shams1802/Spot_RoboDog/spotMicro/assets/8_left_link2_config_step_1.png

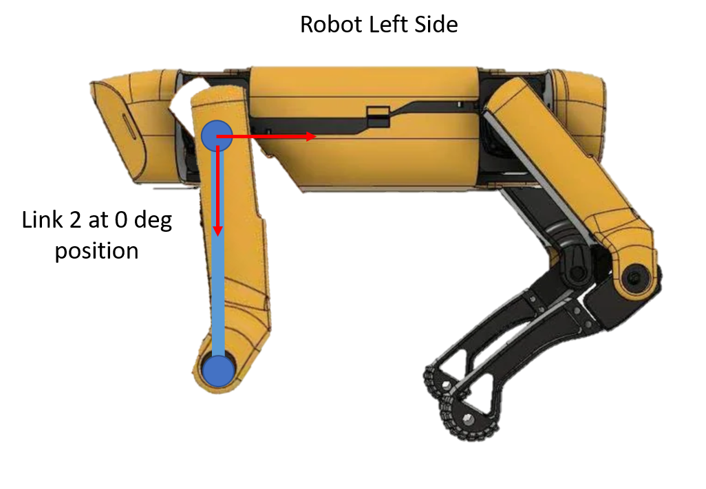
spotMicro/assets/8_left_link2_config_step_1.png
