shams1802/Spot_RoboDog/spotMicro/assets/9_left_link2_config_step_2.png

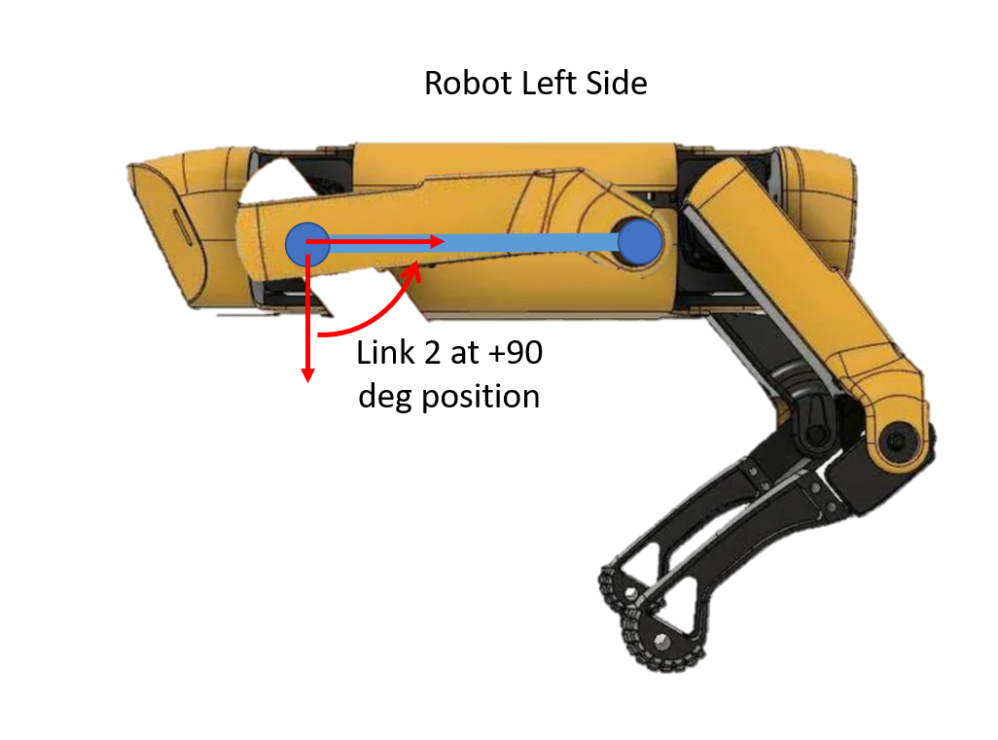
spotMicro/assets/9_left_link2_config_step_2.png
