shams1802/Spot_RoboDog/spotMicro/assets/1_robot_right_links.png

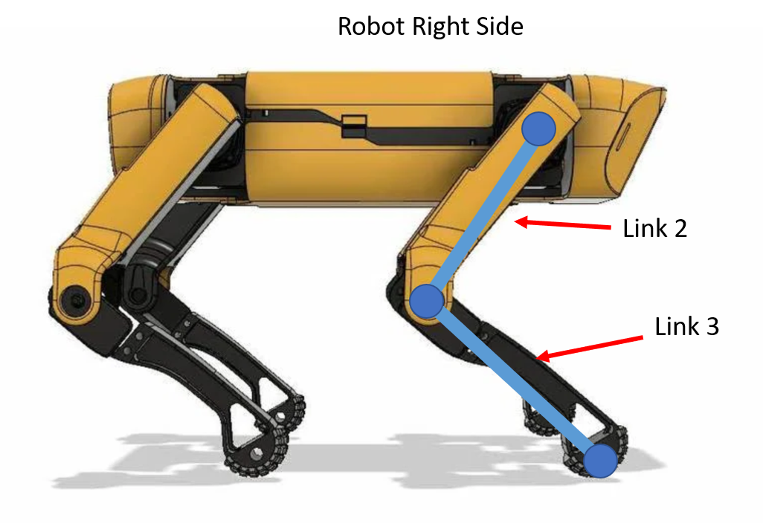
spotMicro/assets/1_robot_right_links.png
