shams1802/Spot_RoboDog/spotMicro/assets/2_right_straight_links.png

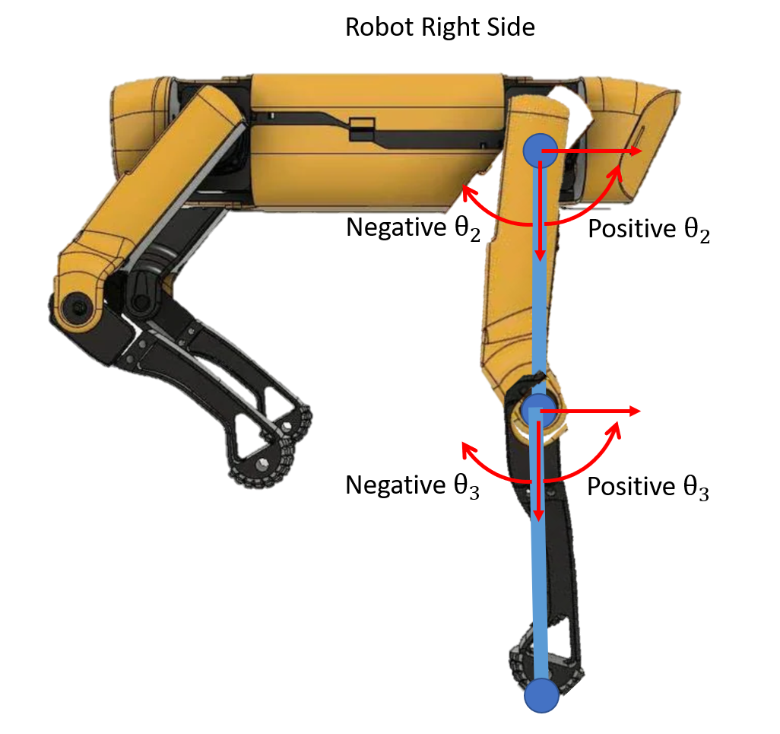
spotMicro/assets/2_right_straight_links.png
