shams1802/Spot_RoboDog/spotMicro/assets/3_right_link_angles_example.png

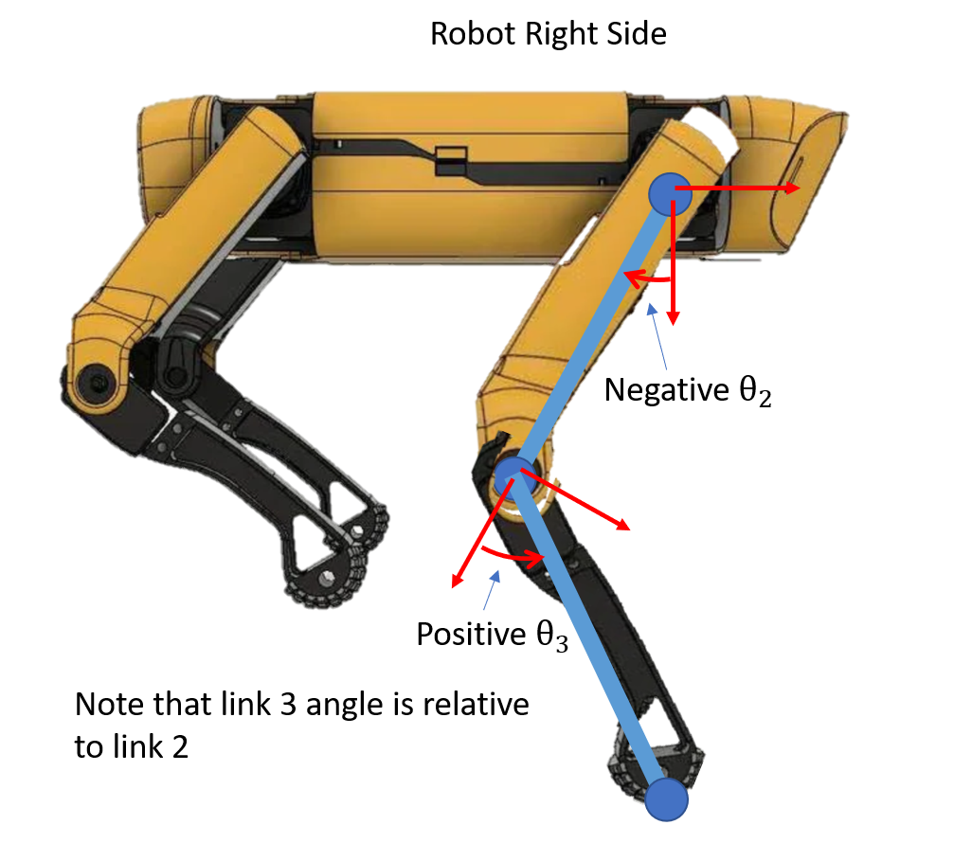
spotMicro/assets/3_right_link_angles_example.png
