shams1802/Spot_RoboDog/spotMicro/assets/7_robot_left_overview.png

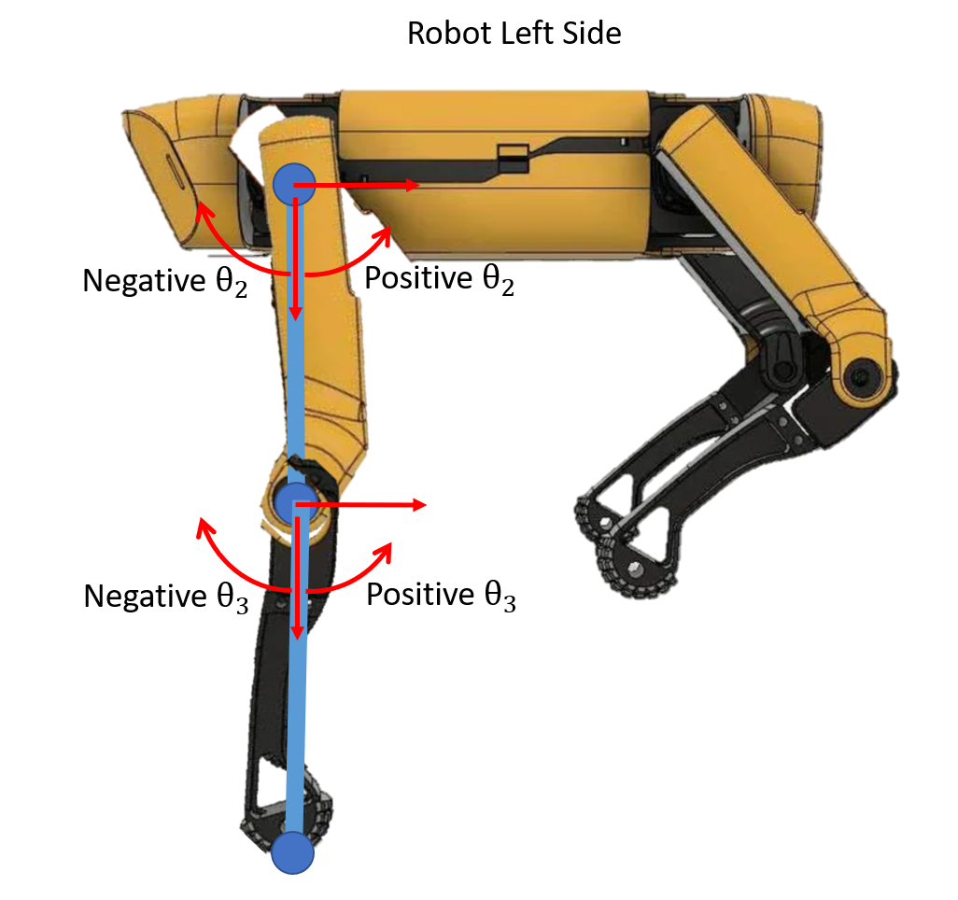
spotMicro/assets/7_robot_left_overview.png
