shams1802/Spot_RoboDog/spotMicro/assets/12_robot_back_overview.png

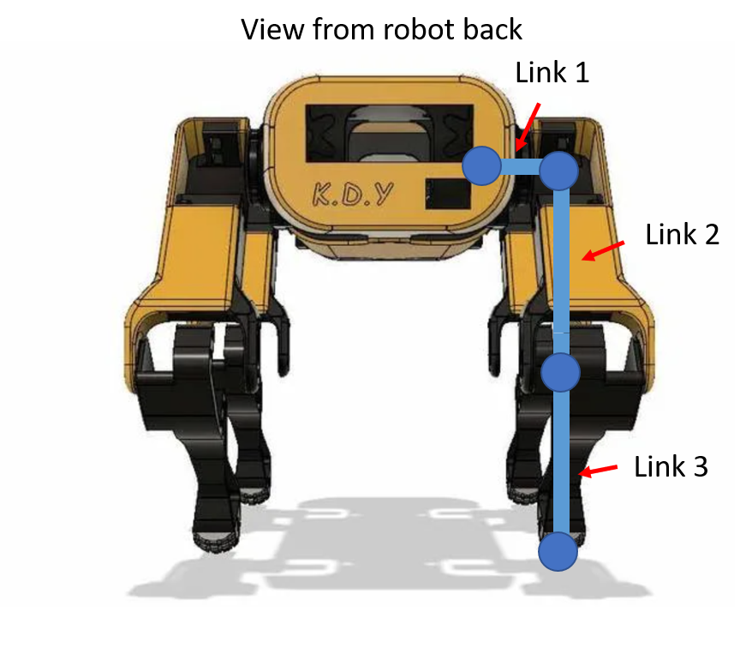
spotMicro/assets/12_robot_back_overview.png
