shams1802/Spot_RoboDog/spotMicro/assets/kinematic_coord_system.jpg

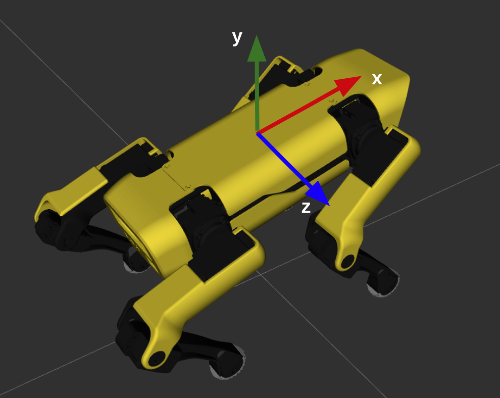
spotMicro/assets/kinematic_coord_system.jpg
