shams1802/Spot_RoboDog/spotMicro/assets/lidar_mount.jpg

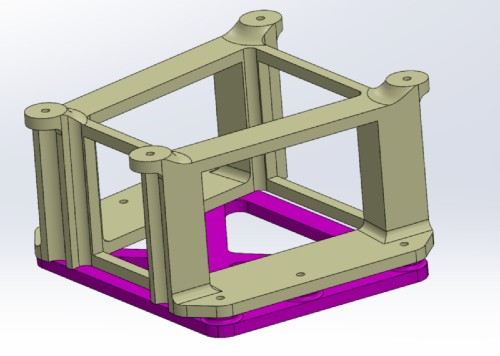
spotMicro/assets/lidar_mount.jpg
