shams1802/Spot_RoboDog/spotMicro/assets/robot_bottom.jpg

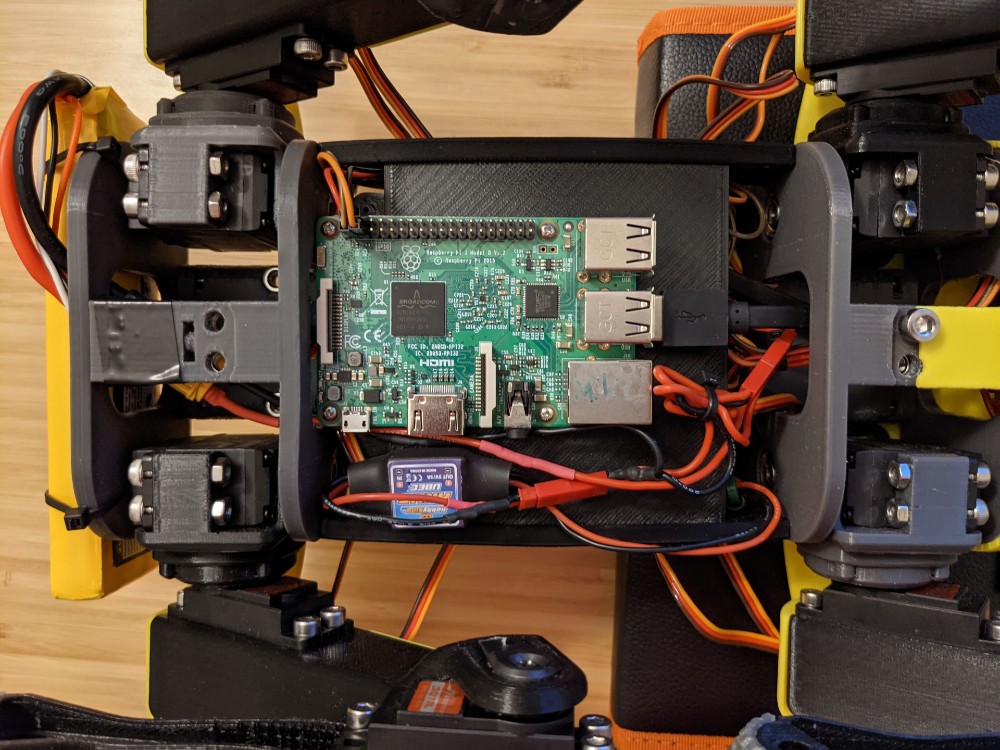
spotMicro/assets/robot_bottom.jpg
