shams1802/Spot_RoboDog/spotMicro/assets/robot_top.jpg

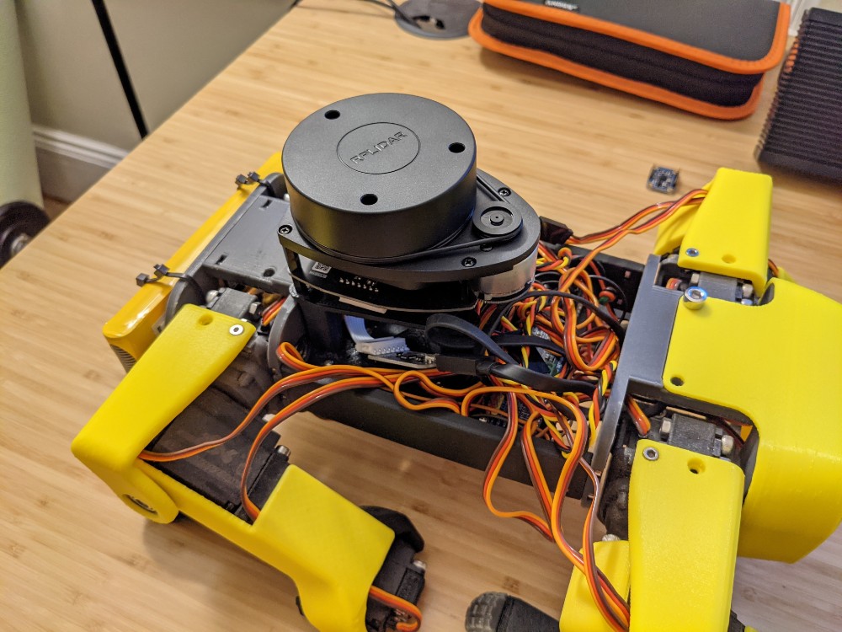
spotMicro/assets/robot_top.jpg
