shams1802/Spot_RoboDog/spotMicro/assets/robot_top_no_servos.jpg

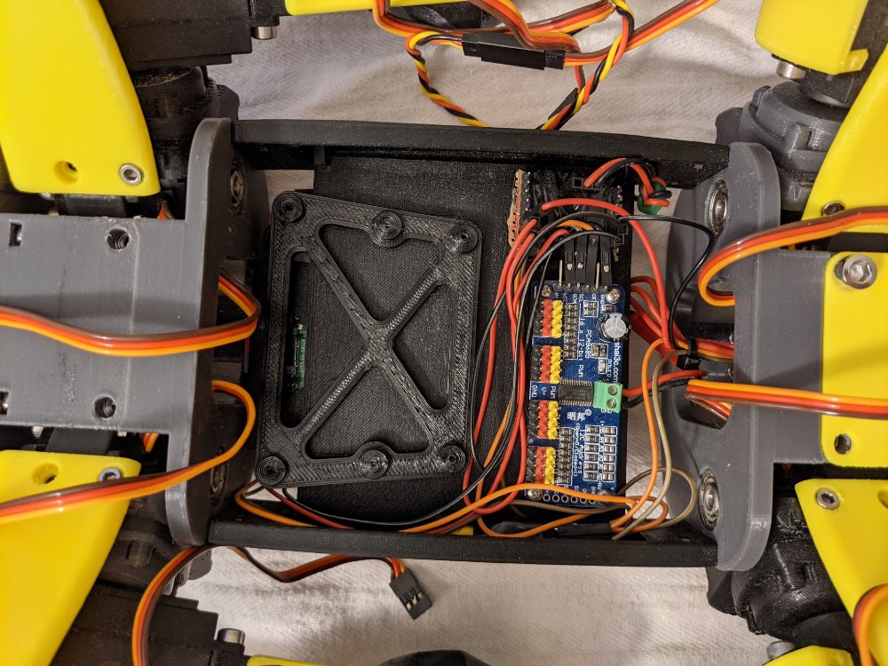
spotMicro/assets/robot_top_no_servos.jpg
