shams1802/Spot_RoboDog/spotMicro/assets/rpi_platform.jpg

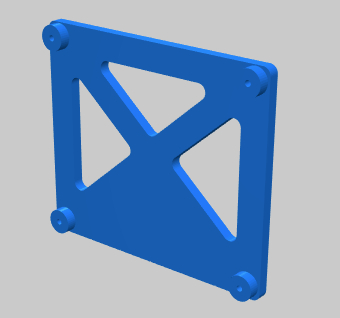
spotMicro/assets/rpi_platform.jpg
