shams1802/Spot_RoboDog/spotMicro/assets/rviz_animation.gif

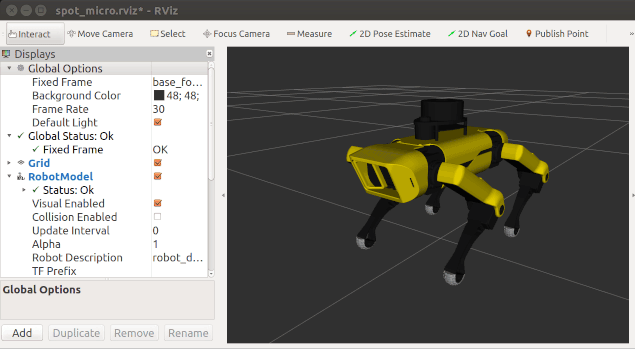
spotMicro/assets/rviz_animation.gif
