shams1802/Spot_RoboDog/spotMicro/assets/servo_move_prompt.png

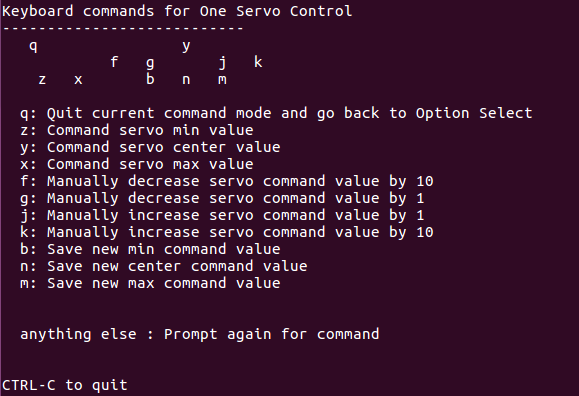
spotMicro/assets/servo_move_prompt.png
