shams1802/Spot_RoboDog/spotMicro/assets/spot_micro_slam.gif

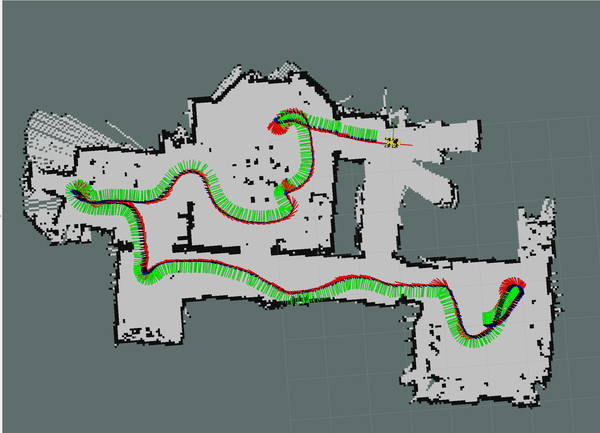
spotMicro/assets/spot_micro_slam.gif
