shams1802/Spot_RoboDog/spotMicro/assets/state_machine.png

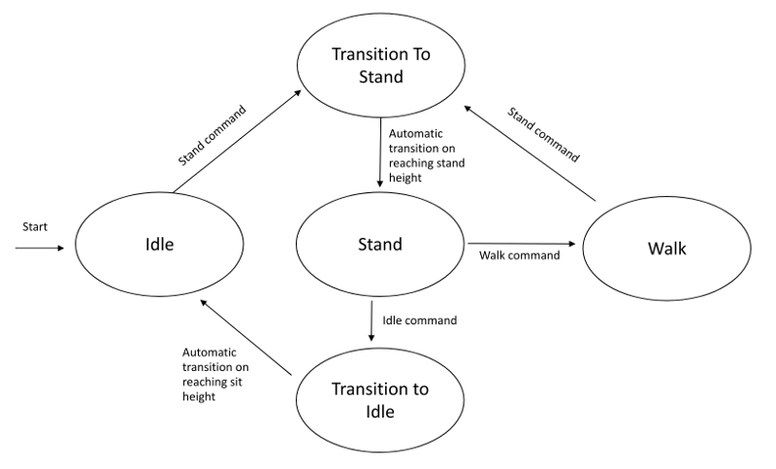
spotMicro/assets/state_machine.png
