shams1802/Spot_RoboDog/spotMicro/assets/tf2_coord_system.jpg

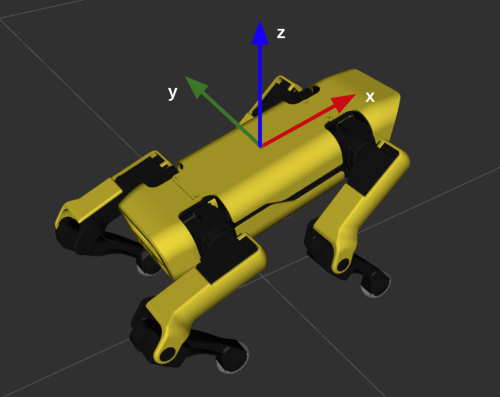
spotMicro/assets/tf2_coord_system.jpg
