shams1802/Spot_RoboDog/spotMicro/spot_micro_rviz/urdf/stl/mainbody.stl

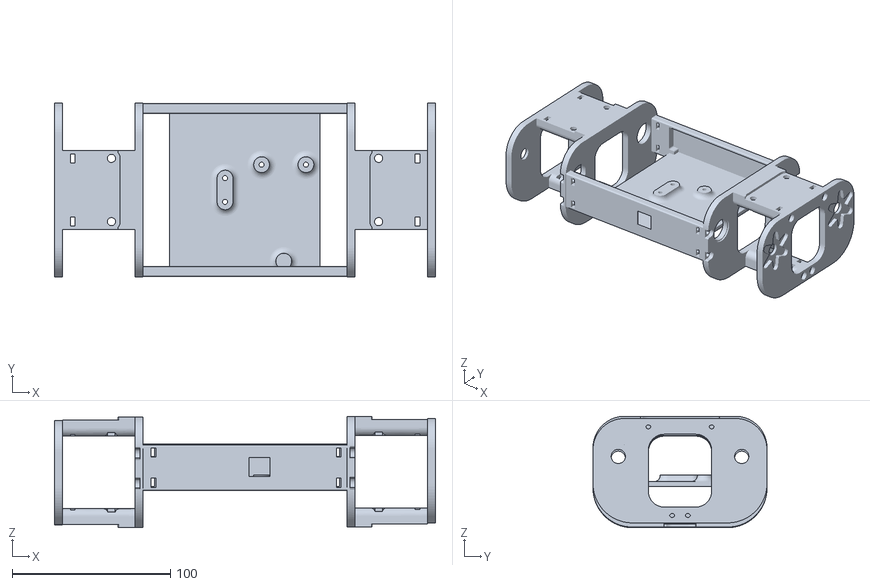
[picture p47: CAD file, 2025-09-26]
spotMicro/spot_micro_rviz/urdf/stl/mainbody.stl
240.7 x 110.0 x 70.4
