shams1802/Spot_RoboDog/spotMicro/spot_micro_rviz/urdf/stl/rplidar_main.STL

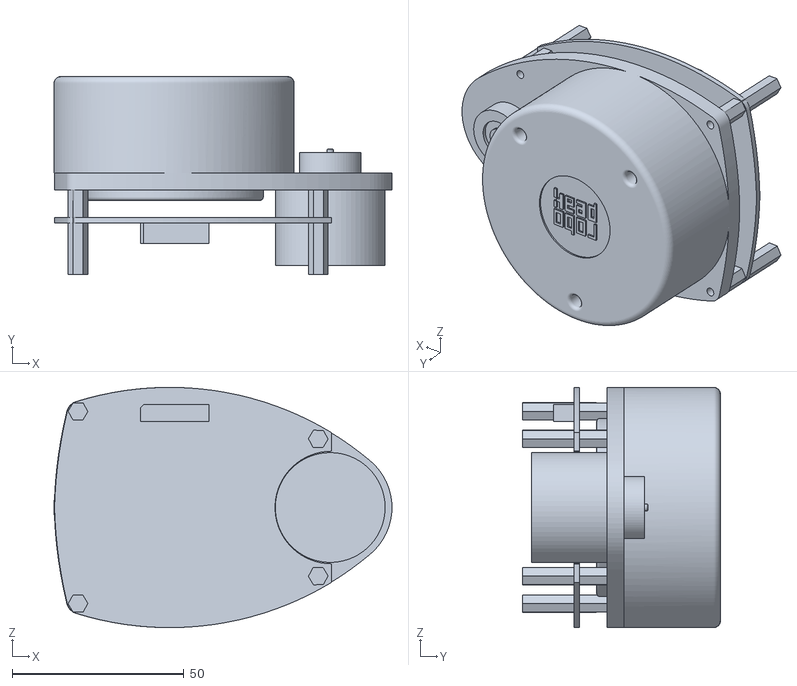
[picture p48: CAD file, 2025-09-26]
spotMicro/spot_micro_rviz/urdf/stl/rplidar_main.STL
98.5 x 57.7 x 70.0
