shams1802/Spot_RoboDog/quadruped-robot/CAD/derived-model/Assem4.SLDASM

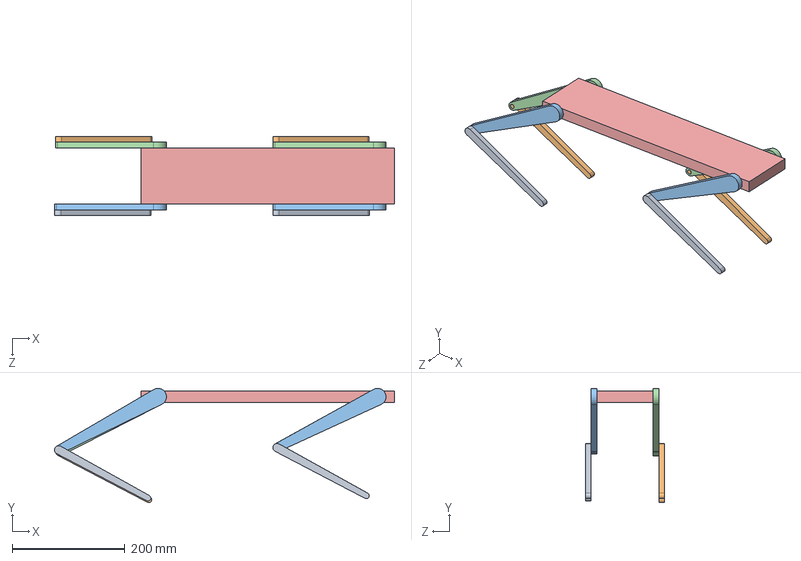
[picture p49: CAD file, 2025-09-27]
quadruped-robot/CAD/derived-model/Assem4.SLDASM
603.8 x 203.1 x 140.0 mm
leg1 x 2
leg2 x 2
thigh1 x 2
thigh2 x 2
base1
