shams1802/Spot_RoboDog/quadruped-robot/base1_Default_sldprt.STEP

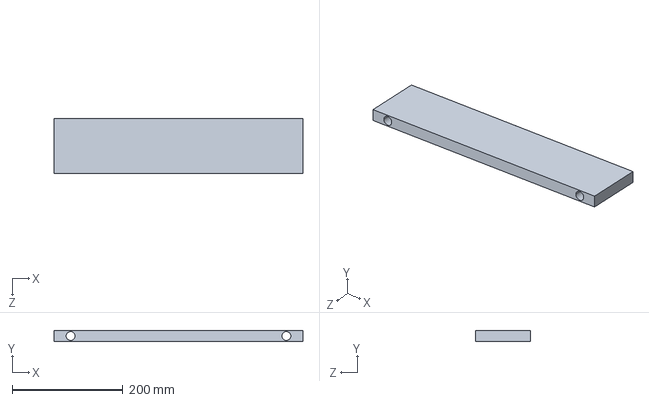
[picture p50: CAD file, 2025-09-27]
quadruped-robot/base1_Default_sldprt.STEP
450.0 x 20.0 x 100.0 mm
