shams1802/Spot_RoboDog/quadruped-robot/CAD/Design1/connecting-rod.sldprt

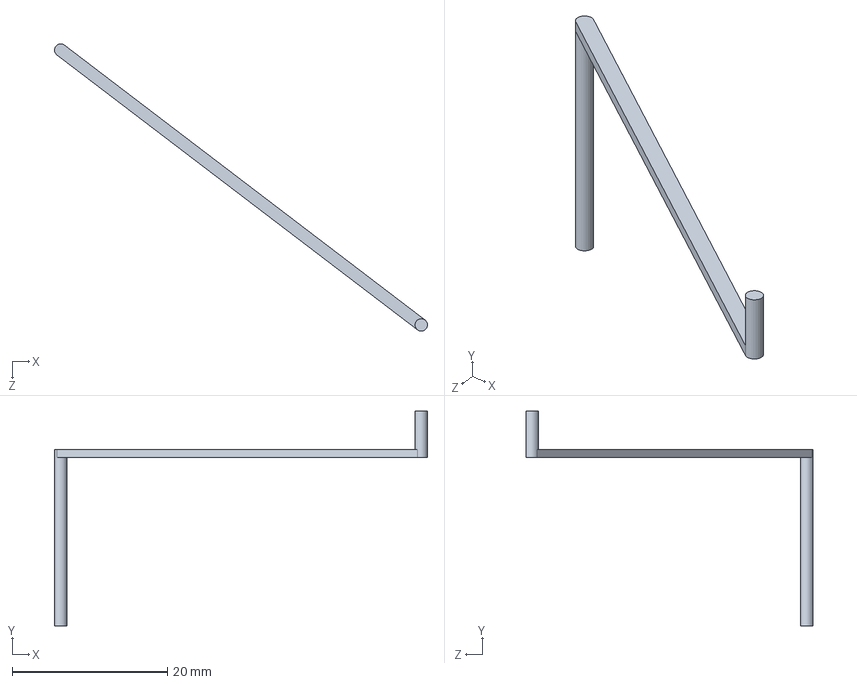
[picture p51: CAD file, 2025-09-27]
quadruped-robot/CAD/Design1/connecting-rod.sldprt
48.0 x 27.6 x 37.0 mm
