shams1802/Spot_RoboDog/quadruped-robot/meshes/body_v1.stl

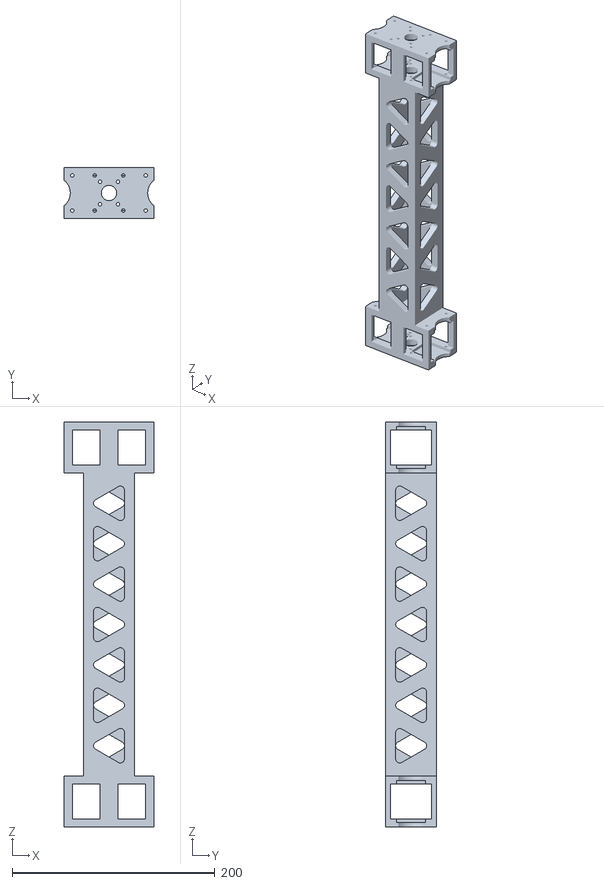
[picture p52: CAD file, 2025-09-26]
quadruped-robot/meshes/body_v1.stl
88.3 x 50.2 x 399.3
