shams1802/Spot_RoboDog/spotMicro/spot_micro_rviz/urdf/stl/rarm.stl

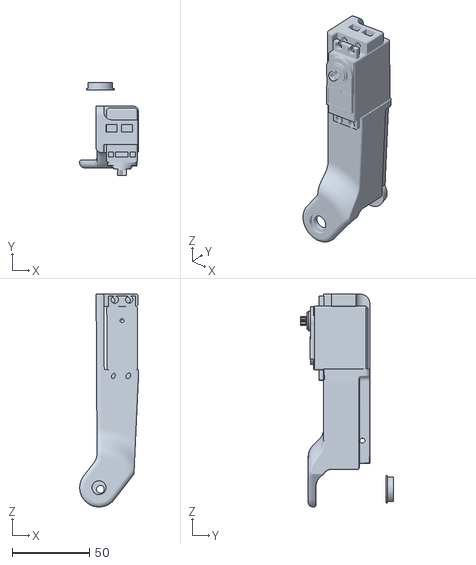
[picture p53: CAD file, 2025-09-26]
spotMicro/spot_micro_rviz/urdf/stl/rarm.stl
37.9 x 60.2 x 137.5
