shams1802/Spot_RoboDog/quadruped-robot/leg2_Default_sldprt.STEP

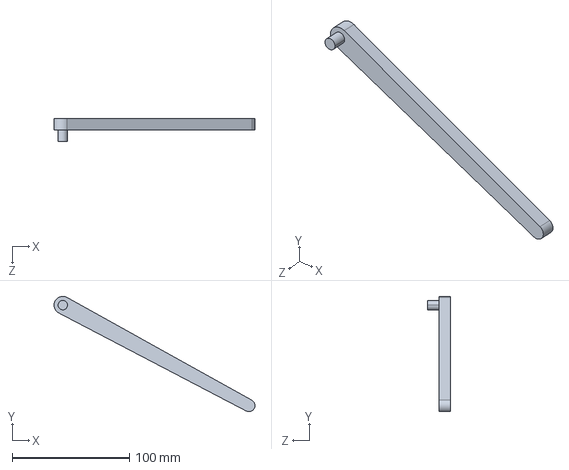
[picture p54: CAD file, 2025-09-27]
quadruped-robot/leg2_Default_sldprt.STEP
171.1 x 98.1 x 20.0 mm
