shams1802/Spot_RoboDog/quadruped-robot/meshes/leg_lower_v3.stl

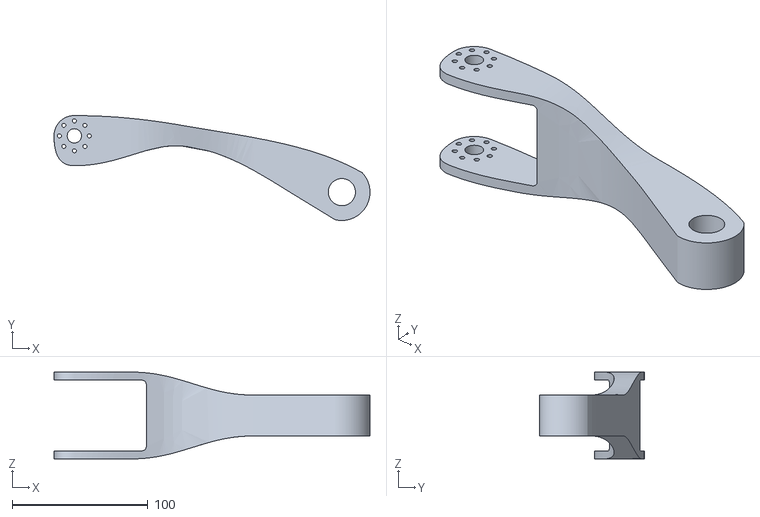
[picture p55: CAD file, 2025-09-26]
quadruped-robot/meshes/leg_lower_v3.stl
232.9 x 77.4 x 64.0
