shams1802/Spot_RoboDog/quadruped-robot/CAD/derived-model/Part1.SLDPRT

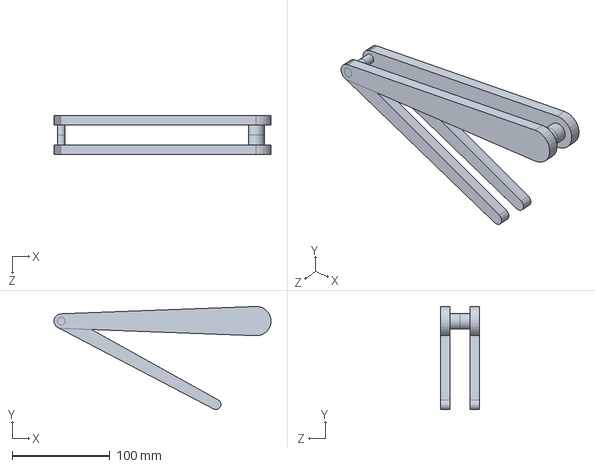
[picture p56: CAD file, 2025-09-27]
quadruped-robot/CAD/derived-model/Part1.SLDPRT
222.4 x 105.6 x 40.0 mm
