shams1802/Spot_RoboDog/quadruped-robot/meshes/coupler_v1.stl

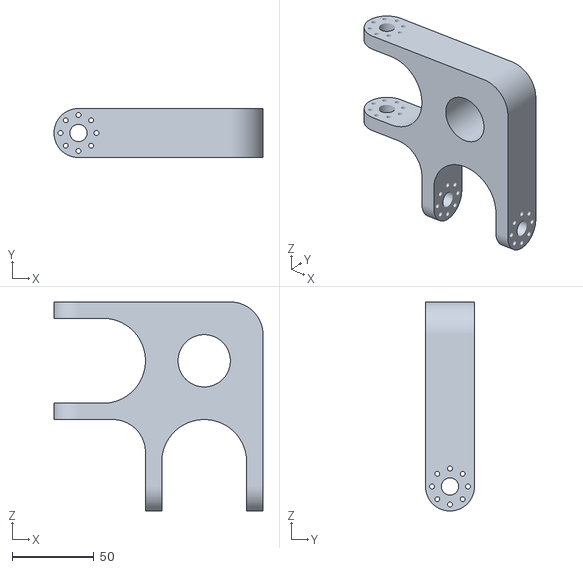
[picture p57: CAD file, 2025-09-26]
quadruped-robot/meshes/coupler_v1.stl
128.0 x 30.0 x 128.0
