shams1802/Spot_RoboDog/quadruped-robot/New folder/thigh1_Default_sldprt.STEP

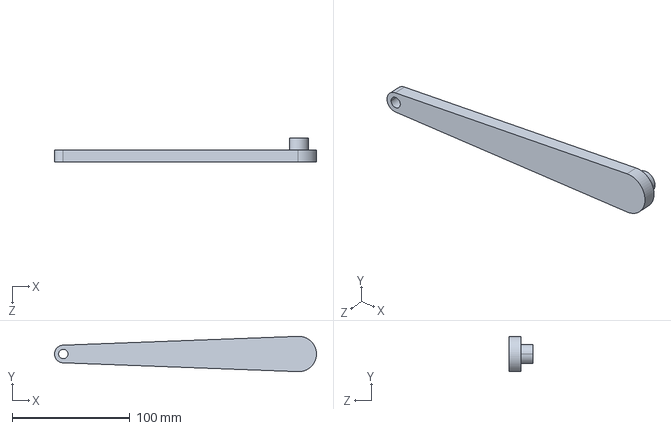
[picture p58: CAD file, 2025-09-27]
quadruped-robot/New folder/thigh1_Default_sldprt.STEP
222.5 x 30.0 x 20.0 mm
