shams1802/Spot_RoboDog/spotMicro/spot_micro_rviz/urdf/stl/lfoot.stl

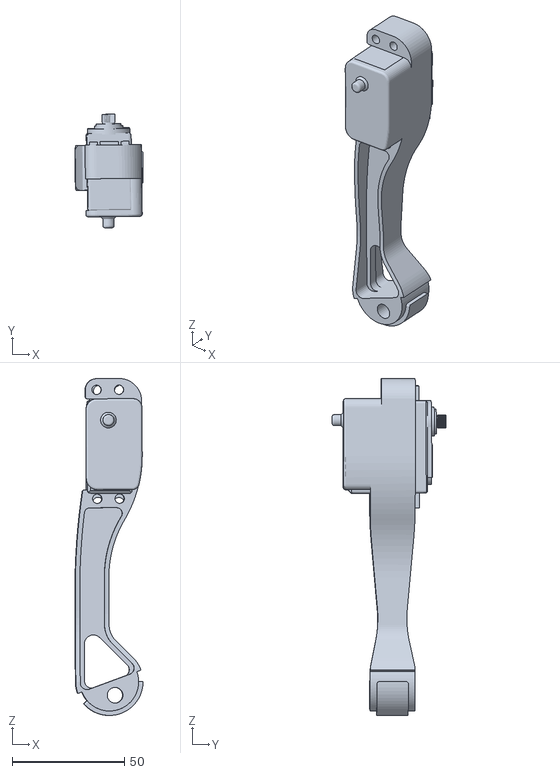
[picture p59: CAD file, 2025-09-26]
spotMicro/spot_micro_rviz/urdf/stl/lfoot.stl
30.4 x 50.7 x 150.0
