shams1802/Spot_RoboDog/quadruped-robot/meshes/leg_upper_v1.5.stl

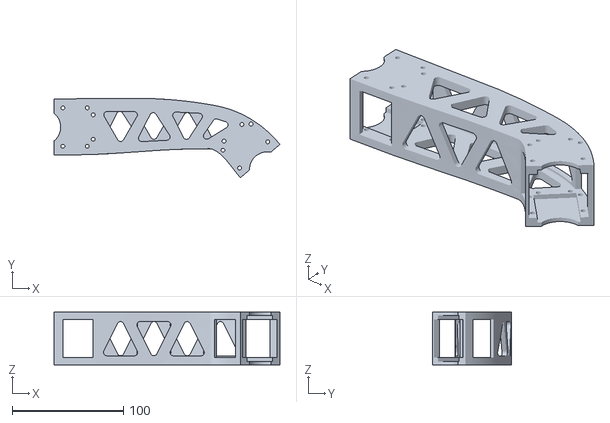
[picture p60: CAD file, 2025-09-26]
quadruped-robot/meshes/leg_upper_v1.5.stl
203.6 x 71.6 x 47.5
