shams1802/Spot_RoboDog/quadruped-robot/CAD/derived-model/base1.SLDPRT

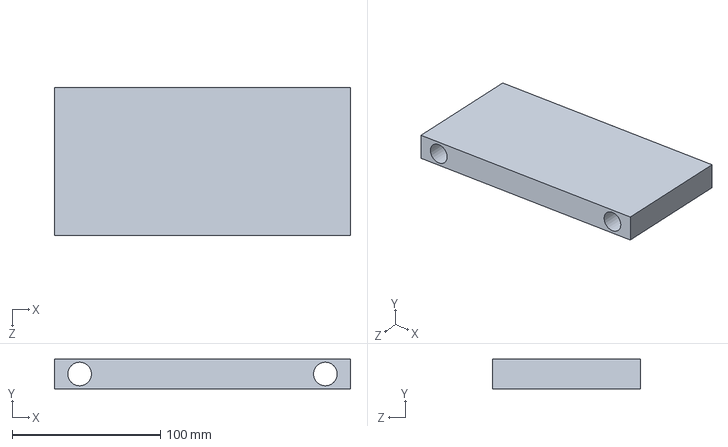
[picture p61: CAD file, 2025-09-27]
quadruped-robot/CAD/derived-model/base1.SLDPRT
200.0 x 20.0 x 100.0 mm
