shams1802/Spot_RoboDog/spotMicro/spot_micro_rviz/urdf/stl/foot.stl

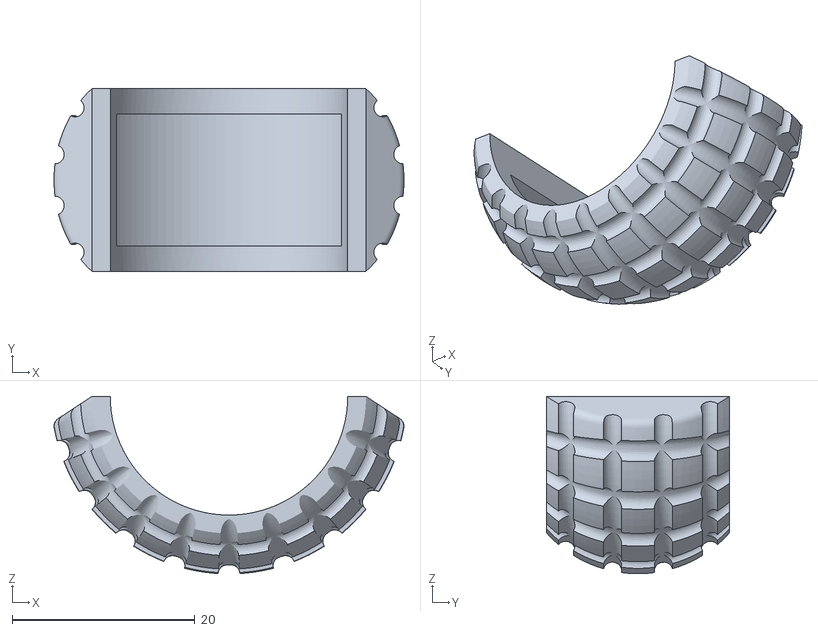
[picture p62: CAD file, 2025-09-26]
spotMicro/spot_micro_rviz/urdf/stl/foot.stl
38.3 x 20.0 x 19.4
