shams1802/Spot_RoboDog/spotMicro/spot_micro_rviz/urdf/stl/backpart.stl

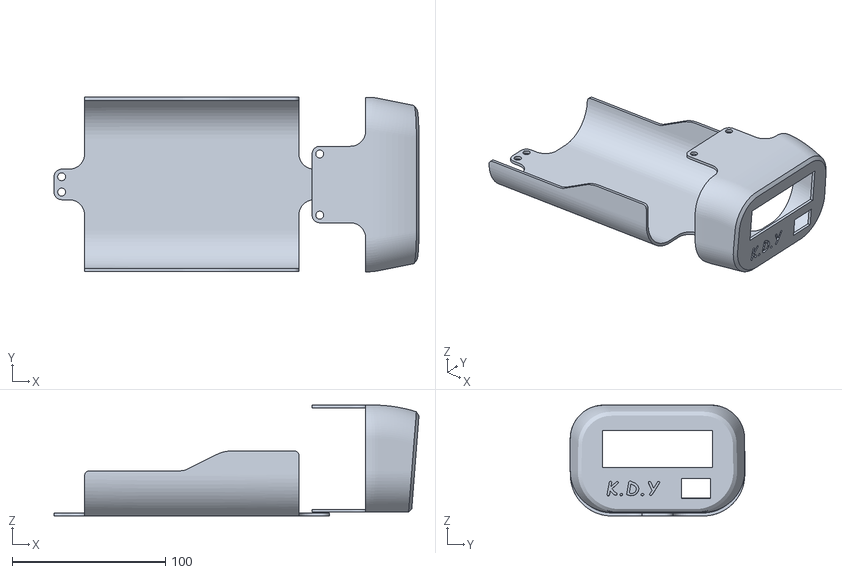
[picture p63: CAD file, 2025-09-26]
spotMicro/spot_micro_rviz/urdf/stl/backpart.stl
238.4 x 114.1 x 72.5
