shams1802/Spot_RoboDog/spotMicro/spot_micro_rviz/urdf/stl/rarm_cover.stl

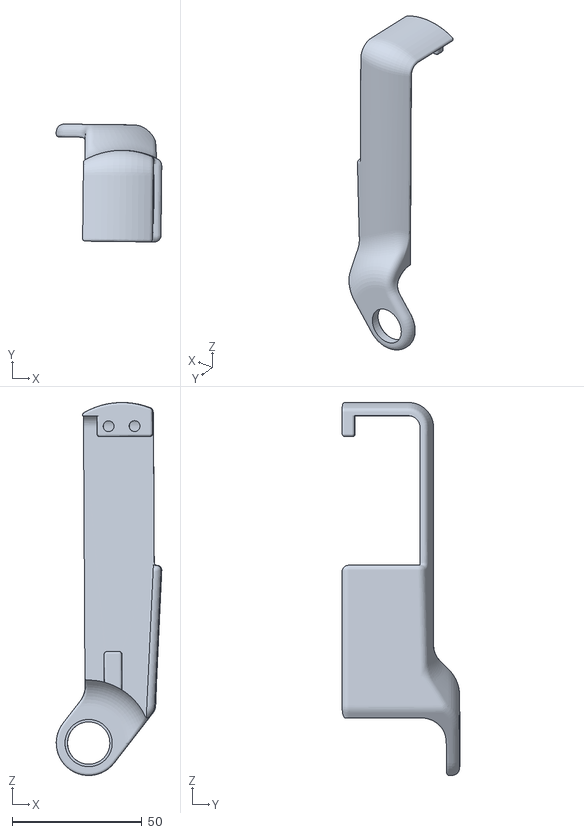
[picture p64: CAD file, 2025-09-26]
spotMicro/spot_micro_rviz/urdf/stl/rarm_cover.stl
40.7 x 45.4 x 143.6
