shams1802/Spot_RoboDog/spotMicro/spot_micro_rviz/urdf/stl/frontpart.stl

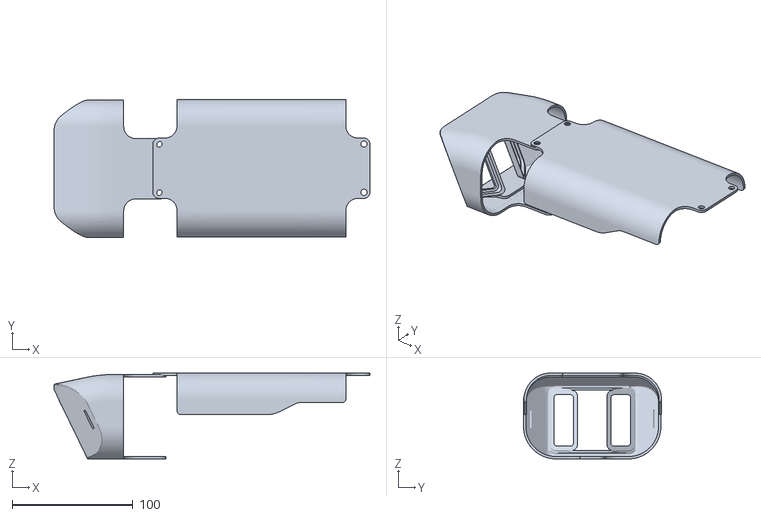
[picture p65: CAD file, 2025-09-26]
spotMicro/spot_micro_rviz/urdf/stl/frontpart.stl
262.0 x 114.5 x 71.2
