shams1802/Spot_RoboDog/spotMicro/spot_micro_rviz/urdf/stl/lshoulder.stl

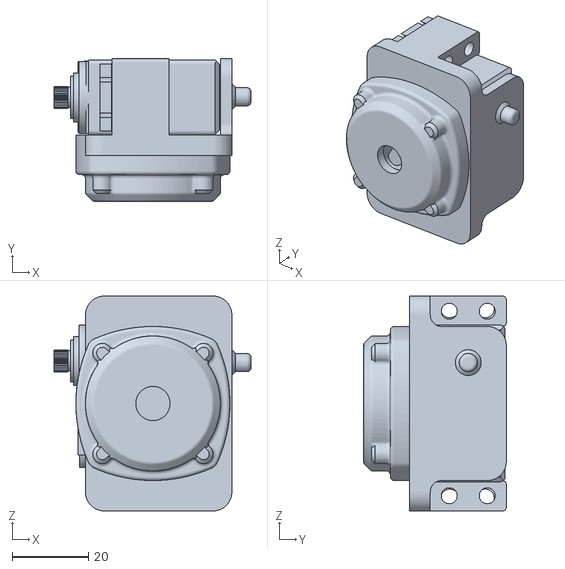
[picture p66: CAD file, 2025-09-26]
spotMicro/spot_micro_rviz/urdf/stl/lshoulder.stl
51.7 x 37.5 x 56.5
