shams1802/Spot_RoboDog/(list of files, cad)

Other CAD files:
quadruped-robot/CAD/derived-model/leg1.sldprt
quadruped-robot/CAD/derived-model/thigh1.sldprt
quadruped-robot/CAD/Design1/L-connector.sldprt
quadruped-robot/New folder/Part7_Default_sldprt.STEP
quadruped-robot/CAD/derived-model/Part7.sldprt
quadruped-robot/CAD/Design1/sg90-servo.sldprt
quadruped-robot/New folder/thigh2_Default_sldprt.STEP
quadruped-robot/Part7_Default_sldprt.STEP
quadruped-robot/New folder/leg1_Default_sldprt.STEP
quadruped-robot/thigh2_Default_sldprt.STEP
quadruped-robot/CAD/derived-model/leg2.sldprt
quadruped-robot/leg1_Default_sldprt.STEP
quadruped-robot/CAD/derived-model/thigh2.sldprt
quadruped-robot/CAD/Design1/pin.sldprt
quadruped-robot/CAD/Design1/lower-leg.sldprt
spotMicro/spot_micro_rviz/urdf/stl/larm_cover.stl
quadruped-robot/CAD/Design1/base.sldprt
spotMicro/spot_micro_rviz/urdf/stl/larm.stl
quadruped-robot/CAD/Design1/thigh.sldprt
quadruped-robot/CAD/Design1/servo arm.sldprt
spotMicro/spot_micro_rviz/urdf/stl/rfoot.stl
spotMicro/spot_micro_rviz/urdf/stl/rshoulder.stl
