shams1802/Spot_RoboDog/quadruped-robot/results_and_screenshots/leg_block_assembly.png

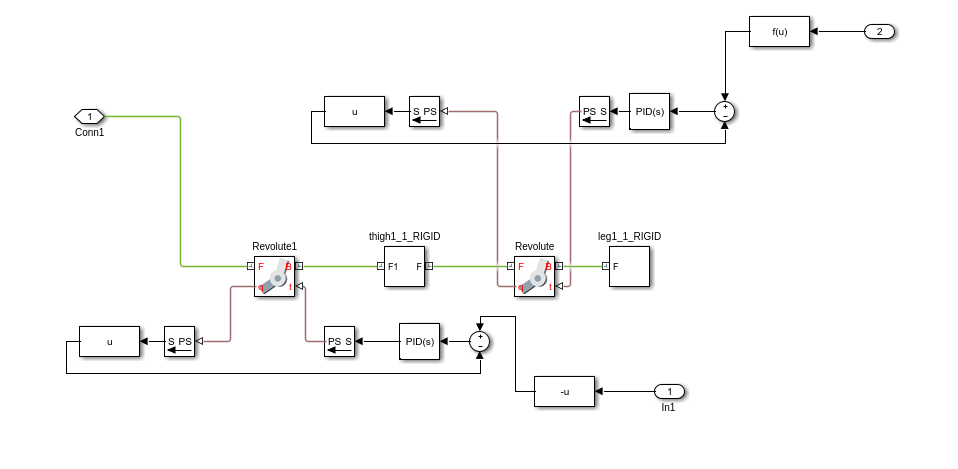
quadruped-robot/results_and_screenshots/leg_block_assembly.png
