shams1802/Spot_RoboDog/quadruped-robot/results_and_screenshots/Mechanical_model_block_assembly.png

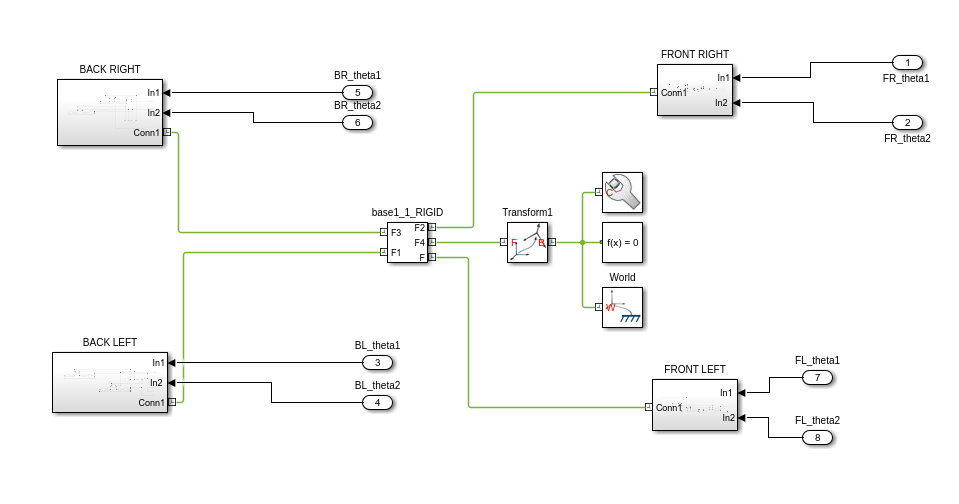
quadruped-robot/results_and_screenshots/Mechanical_model_block_assembly.png
