shams1802/Spot_RoboDog/quadruped-robot/results_and_screenshots/simulink_assembly.png

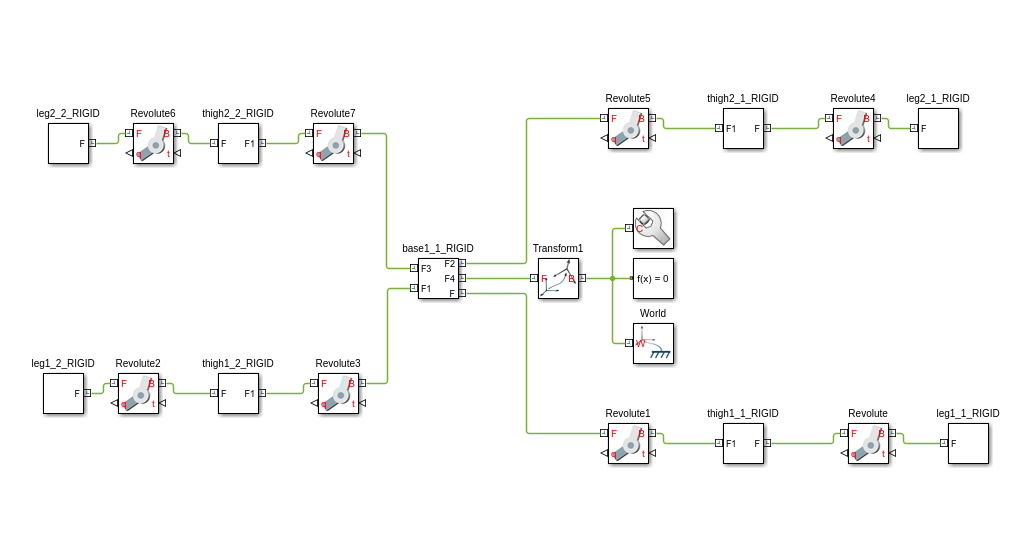
quadruped-robot/results_and_screenshots/simulink_assembly.png
