shams1802/Spot_RoboDog/spotMicro/assets/4_right_link2_config_step_2.png

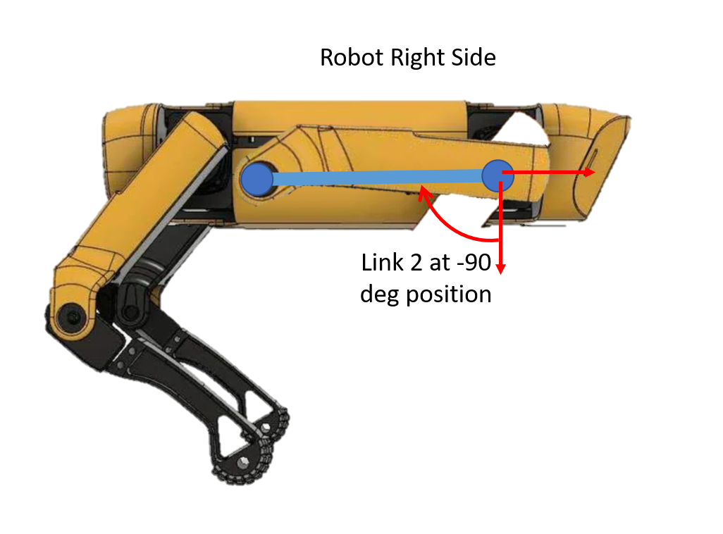
spotMicro/assets/4_right_link2_config_step_2.png
