shams1802/Spot_RoboDog/spotMicro/assets/5_right_link3_config_step_1.png

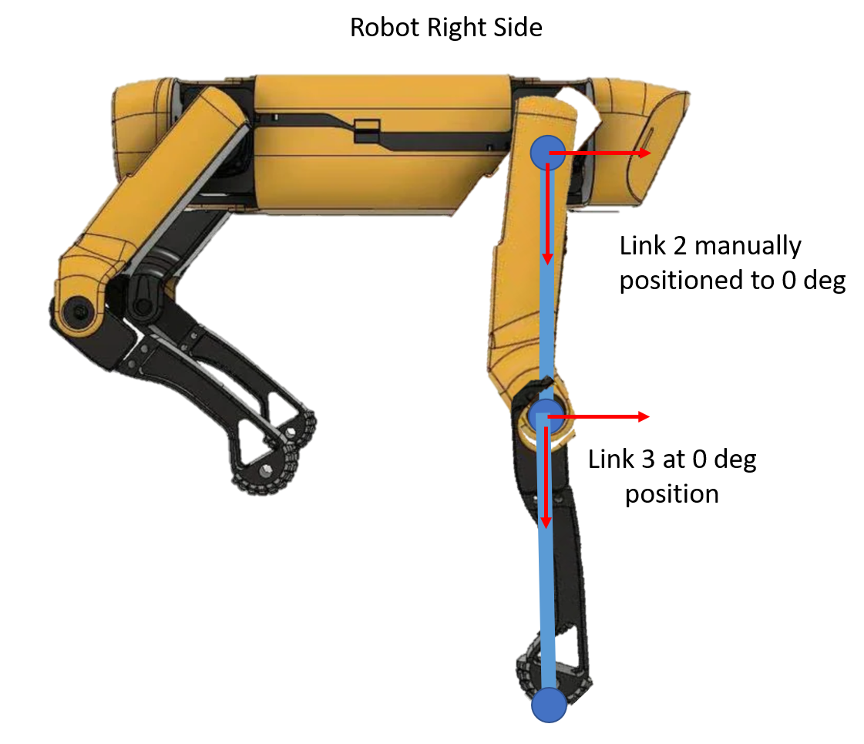
spotMicro/assets/5_right_link3_config_step_1.png
