shams1802/Spot_RoboDog/spotMicro/assets/6_right_link3_config_step_2.png

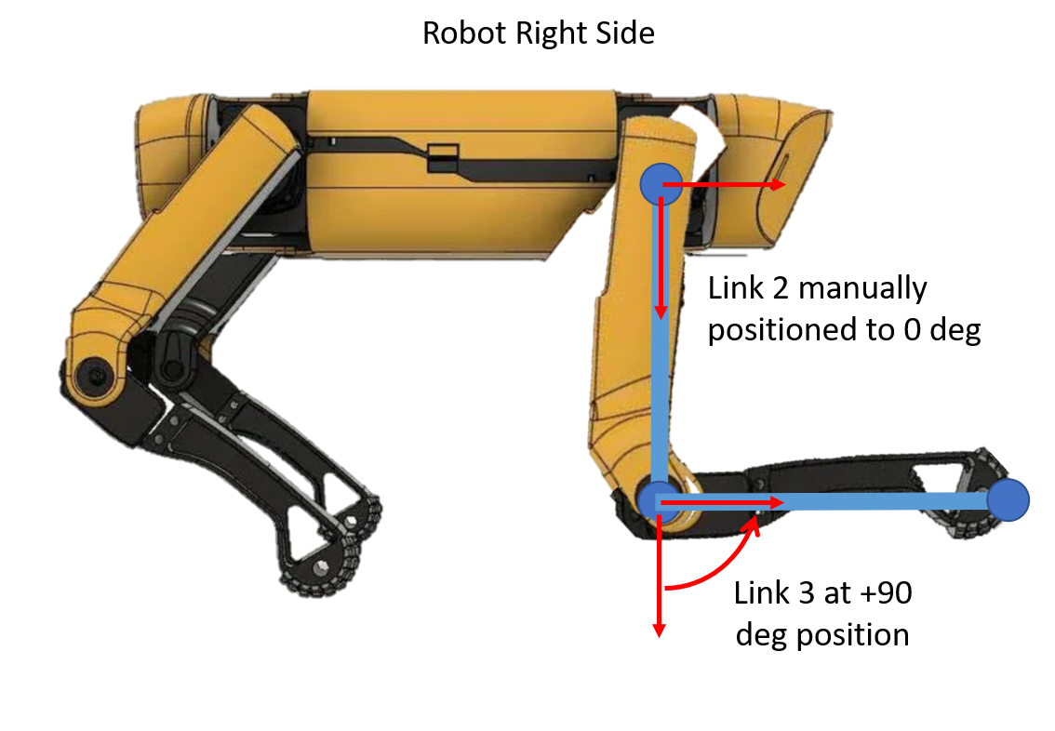
spotMicro/assets/6_right_link3_config_step_2.png
