shams1802/Spot_RoboDog/spotMicro/assets/10_left_link3_config_step_1.png

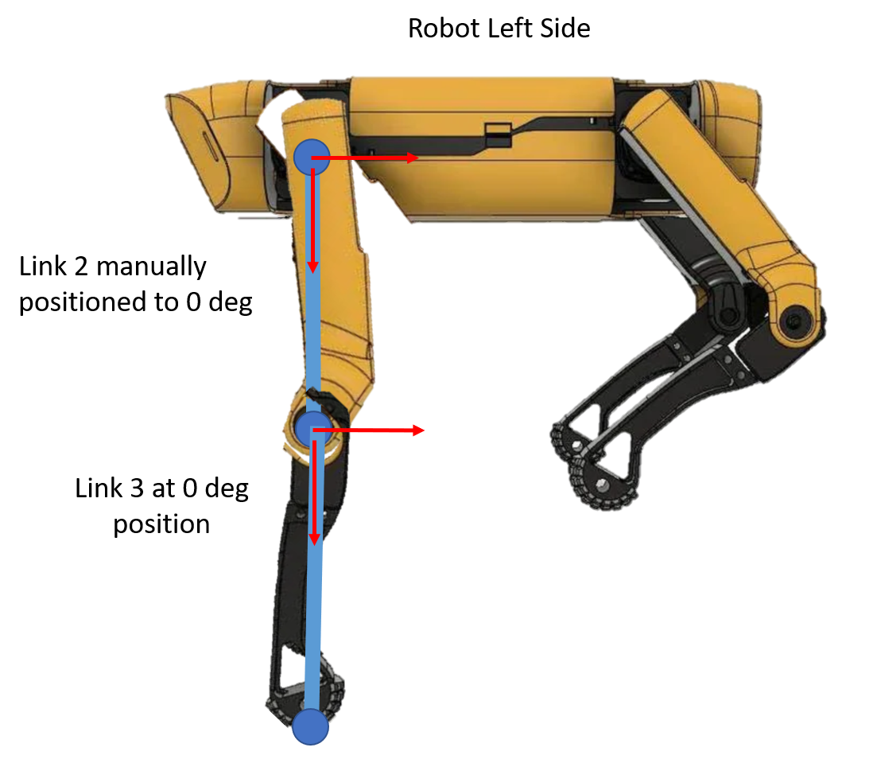
spotMicro/assets/10_left_link3_config_step_1.png
