shams1802/Spot_RoboDog/spotMicro/assets/11_left_link3_config_step_2.png

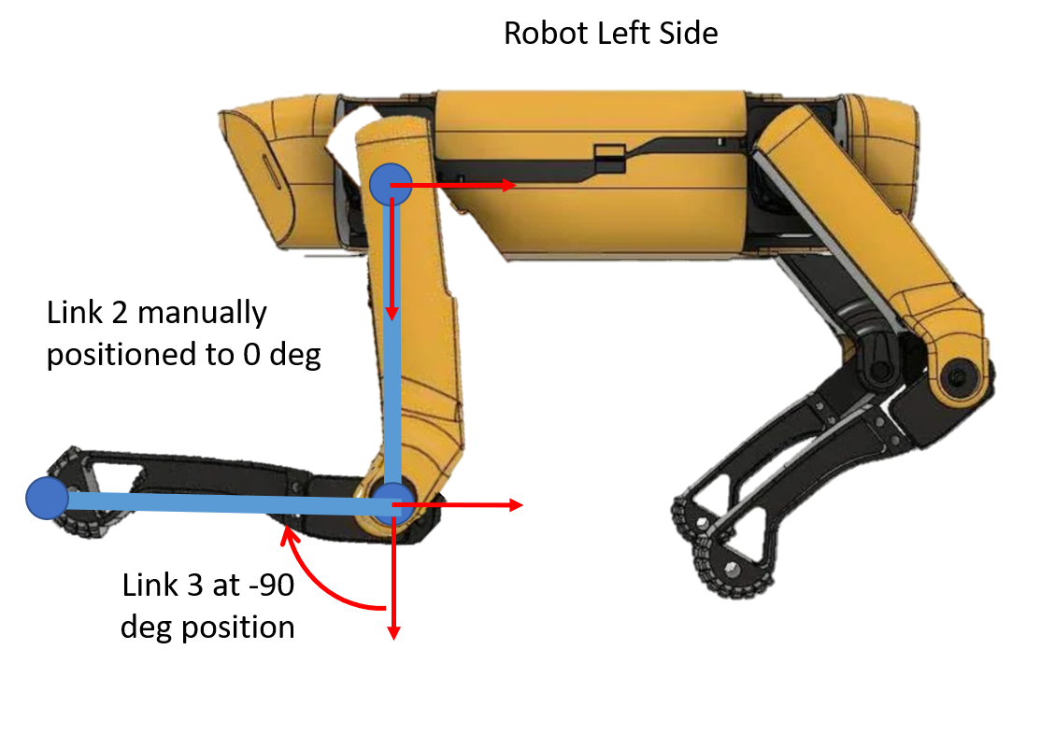
spotMicro/assets/11_left_link3_config_step_2.png
