shams1802/Spot_RoboDog/spotMicro/assets/14_right_link1_config_step_1.png

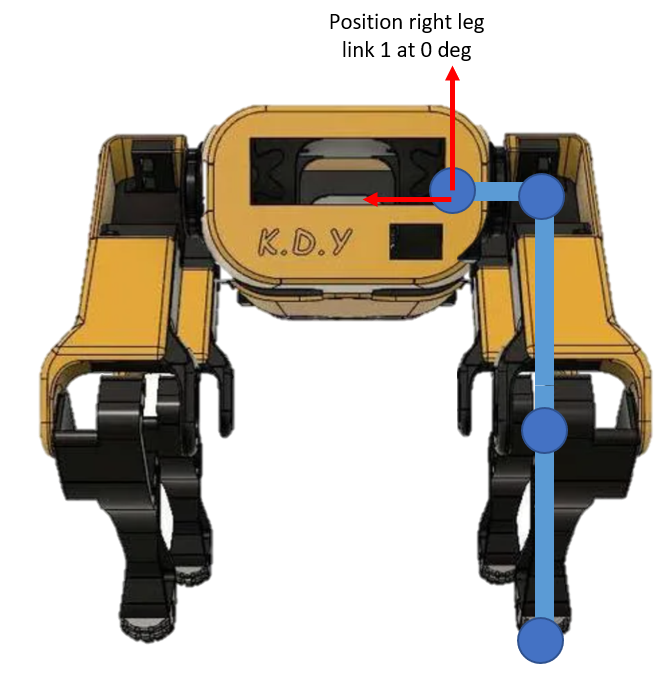
spotMicro/assets/14_right_link1_config_step_1.png
