shams1802/Spot_RoboDog/spotMicro/assets/15_right_link1_config_step_2.png

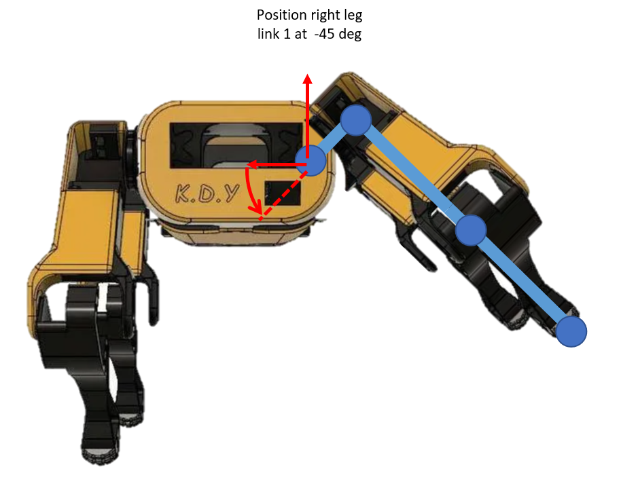
spotMicro/assets/15_right_link1_config_step_2.png
