shams1802/Spot_RoboDog/spotMicro/assets/16_left_link1_config_step_1.png

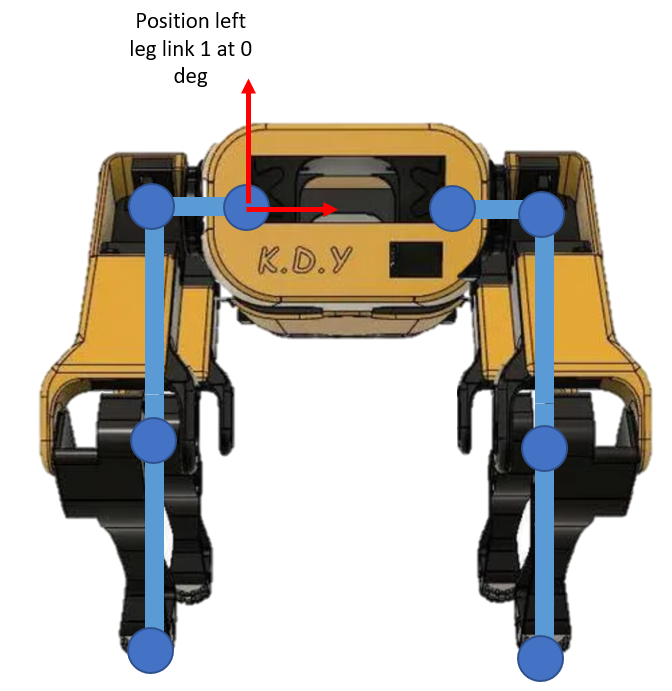
spotMicro/assets/16_left_link1_config_step_1.png
