shams1802/Spot_RoboDog/spotMicro/assets/17_left_link1_config_step_2.png

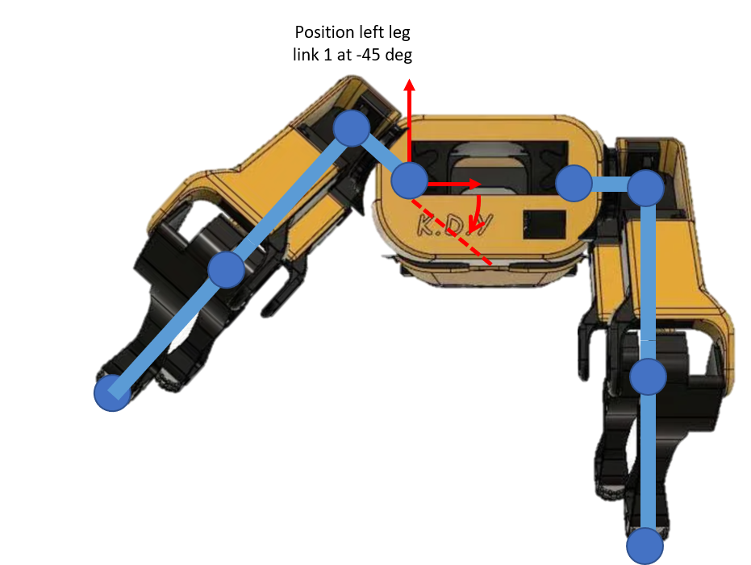
spotMicro/assets/17_left_link1_config_step_2.png
