shams1802/Spot_RoboDog/spotMicro/assets/custom_shoulder_assembly.jpg

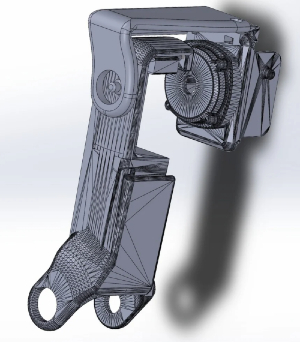
spotMicro/assets/custom_shoulder_assembly.jpg
