shams1802/Spot_RoboDog/spotMicro/docs/servo_calibration_spreadsheet.ods

Servo | Position 1 PWM | Position 2 PWM | Position 1 Angle | Position 2 Angle | Slope (pwm/deg) | Center PWM Val | Calculated Angle at Center PWM Value | PWM val for negative max servo angle from center | PWM val for max servo angle from center | Range | Direction | Link Description
1 | 107 | 310 | 0 | 90 | 2.26 | 306 | 88.23 | 119.92 | 492.08 | 372.2 | 1 | Right front lower leg | Values in bold used for servo configuration
2 | 371 | 159 | 0 | -90 | 2.36 | 306 | -27.59 | 111.67 | 500.33 | 388.7 | 1 | Right front upper leg
3 | 293 | 401 | 0 | -45 | -2.40 | 306 | -5.42 | 504.00 | 108.00 | 396.0 | -1 | Right front hip
4 | 100 | 316 | 0 | 90 | 2.40 | 306 | 85.83 | 108.00 | 504.00 | 396.0 | 1 | Right back lower leg
5 | 175 | 391 | -90 | 0 | 2.40 | 306 | -35.42 | 108.00 | 504.00 | 396.0 | 1 | Right back upper leg
6 | 205 | 317 | -45 | 0 | 2.49 | 306 | -4.42 | 100.67 | 511.33 | 410.7 | 1 | Right back hip
7 | 268 | 481 | -90 | 0 | 2.37 | 306 | -73.94 | 110.75 | 501.25 | 390.5 | 1 | Left back lower leg
8 | 214 | 428 | 0 | 90 | 2.38 | 306 | 38.69 | 109.83 | 502.17 | 392.3 | 1 | Left back upper leg
9 | 305 | 407 | 0 | -45 | -2.27 | 306 | -0.44 | 493.00 | 119.00 | 374.0 | -1 | Left back hip
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
