shams1802/Spot_RoboDog/quadruped-robot/results_and_screenshots/Overall_SimulinkModel.png

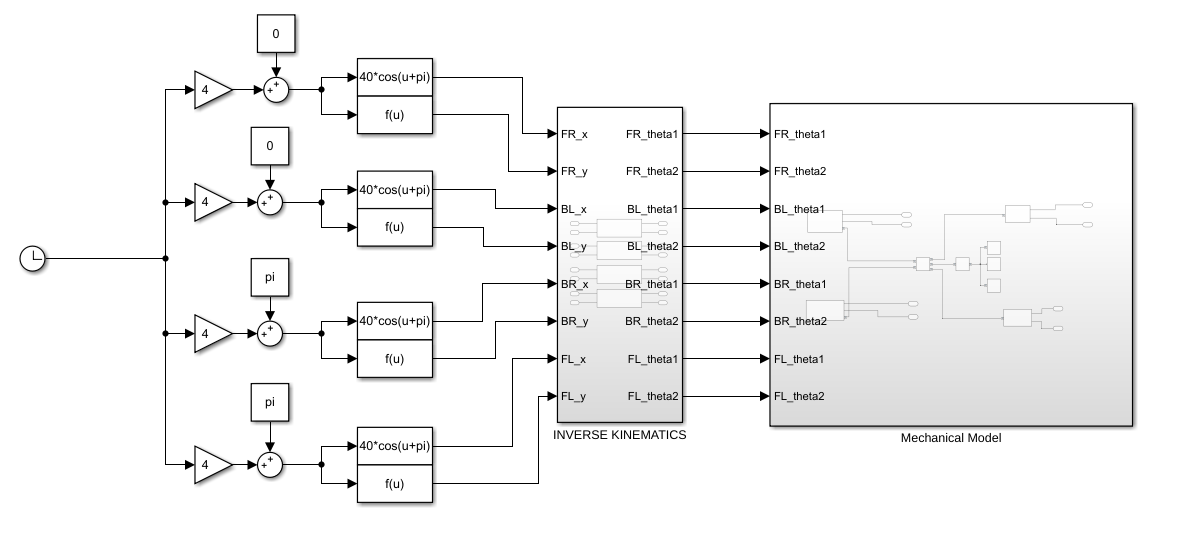
quadruped-robot/results_and_screenshots/Overall_SimulinkModel.png
