shams1802/Spot_RoboDog/quadruped-robot/results_and_screenshots/results/static_walking.png

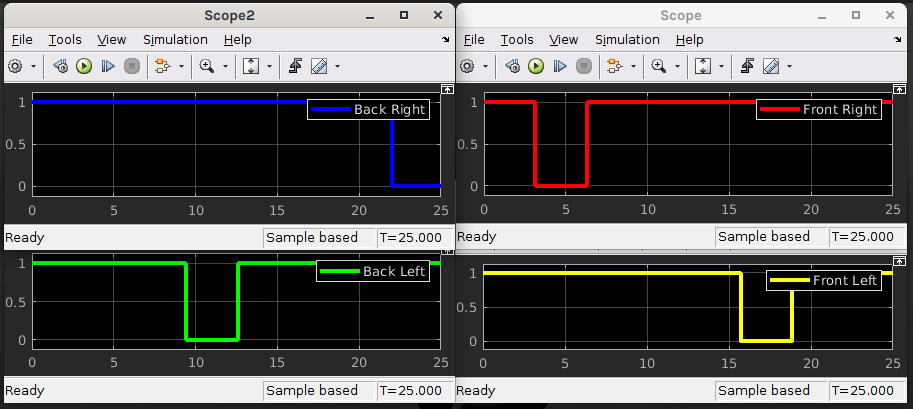
quadruped-robot/results_and_screenshots/results/static_walking.png
