shams1802/Spot_RoboDog/quadruped-robot/results_and_screenshots/results/trotting-graph.png

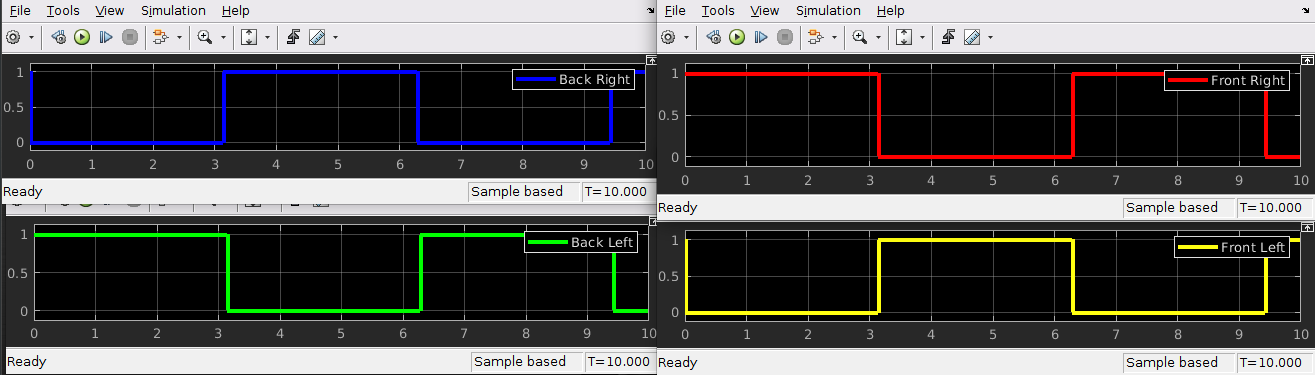
quadruped-robot/results_and_screenshots/results/trotting-graph.png
