shams1802/Spot_RoboDog/quadruped-robot/results_and_screenshots/results/x_and_y_vs _t.png

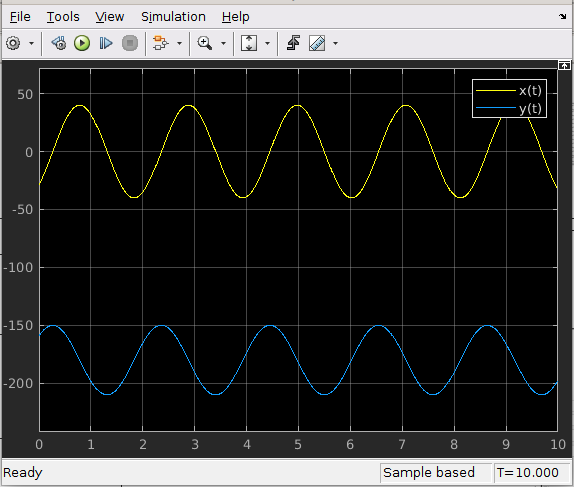
quadruped-robot/results_and_screenshots/results/x_and_y_vs _t.png
