shams1802/Spot_RoboDog/quadruped-robot/results_and_screenshots/Revolute-joint-properties.png

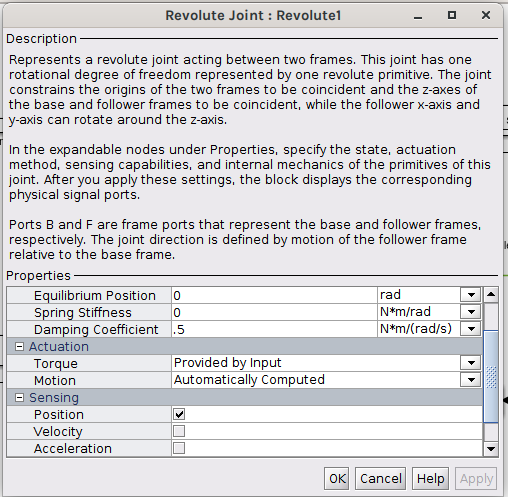
quadruped-robot/results_and_screenshots/Revolute-joint-properties.png
