shams1802/Spot_RoboDog/spotMicro/assets/servo_calibration_spreadsheet.png

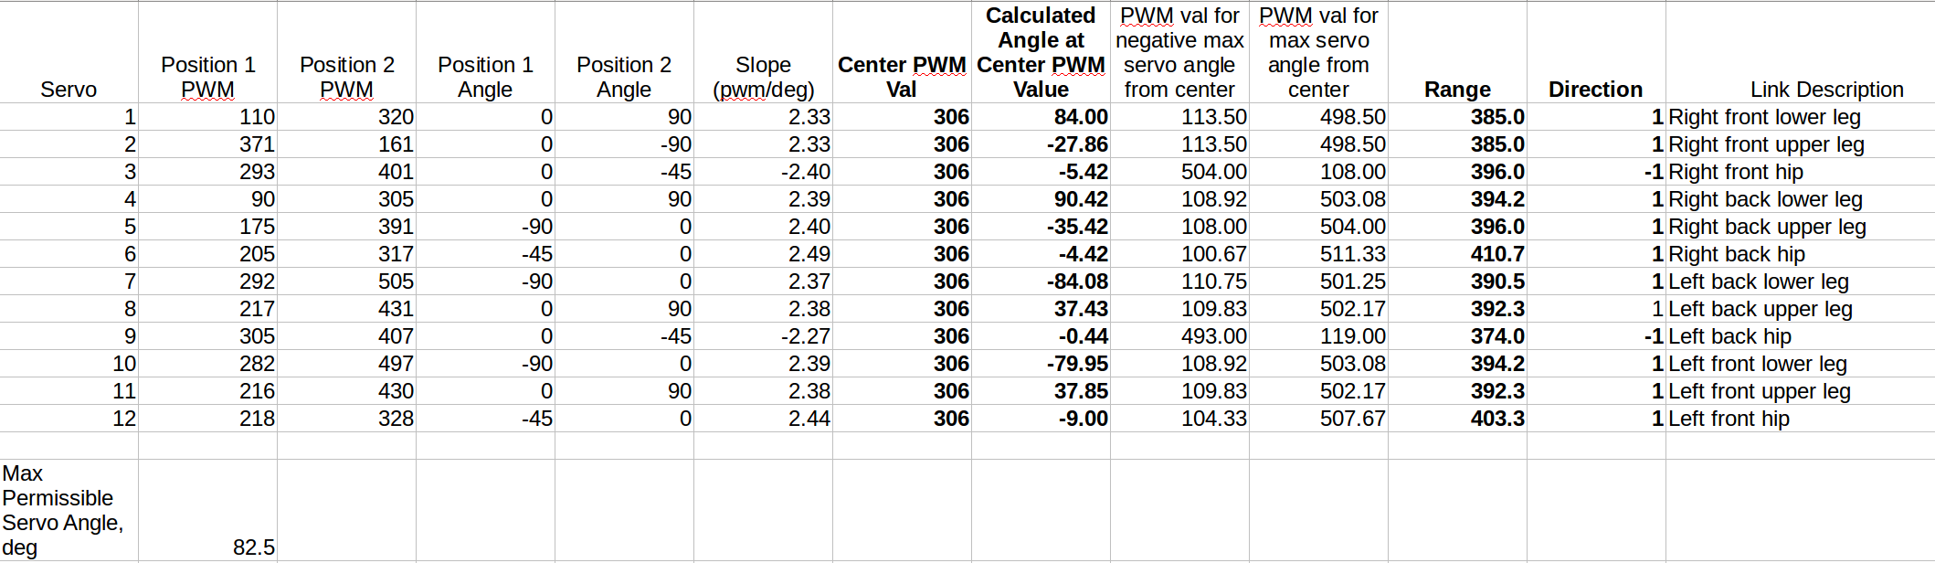
spotMicro/assets/servo_calibration_spreadsheet.png
