shams1802/Spot_RoboDog/(commit log)

2025-09-26 Add spotMicro as normal folder
    [backpart.stl, foot.stl, frontpart.stl, larm.stl, larm_cover.stl, lfoot.stl, lshoulder.stl, mainbody.stl]
2025-09-27 Add Quadruped basic walking animation
    [Assem4.SLDASM, L-connector.sldprt, Part1.SLDPRT, Part7.sldprt, Part7_Default_sldprt.STEP, base.sldprt, base1.SLDPRT, base1_Default_sldprt.STEP]
